MurpheyLab/NoodleBot/swimmer/solidworks/swimmer cap.SLDPRT

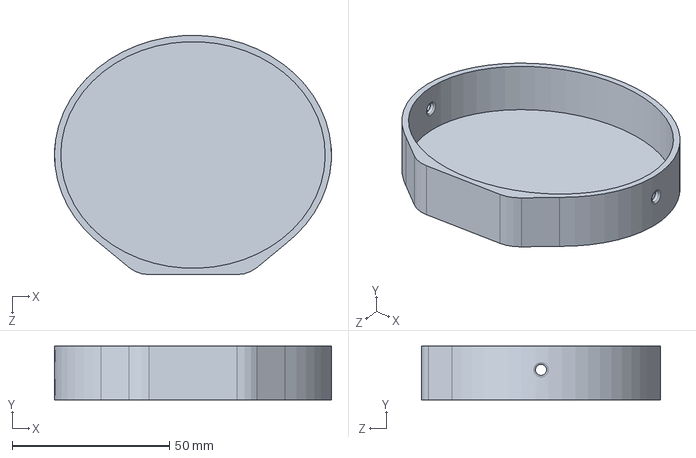
[picture p4: CAD file, 2024-09-23]
swimmer/solidworks/swimmer cap.SLDPRT
88.0 x 17.0 x 76.0 mm
