MurpheyLab/NoodleBot/swimmer/solidworks/large servo bracket.SLDPRT

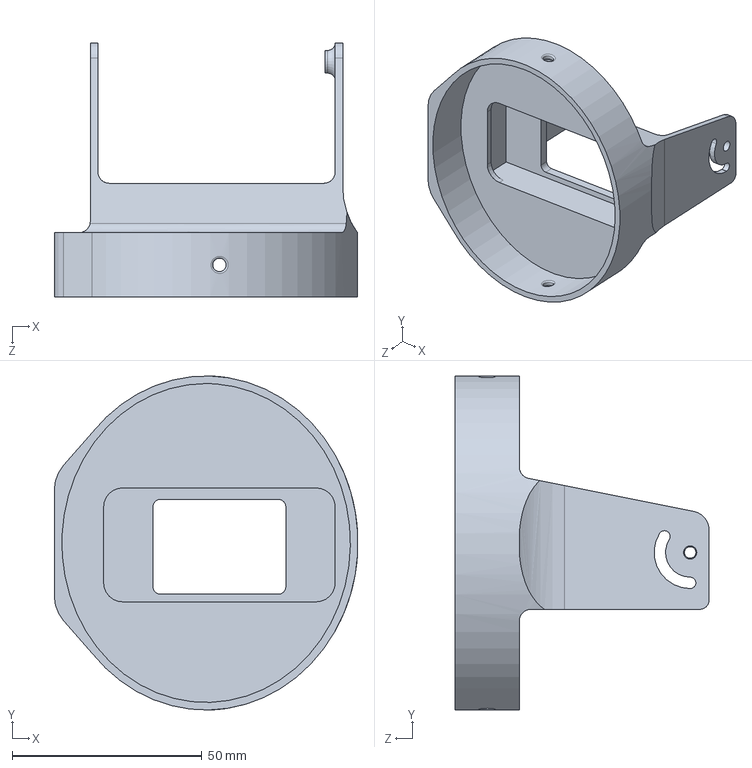
[picture p5: CAD file, 2024-09-23]
swimmer/solidworks/large servo bracket.SLDPRT
79.9 x 88.0 x 67.0 mm
