MurpheyLab/NoodleBot/swimmer/NoodleBot.ini

[devices]
modem1= 1
beacon2= 1
beacon3= 1
beacon4= 1
beacon5= 1
beacon10= 1
beacon11= 1


[zones]
zone0_id= 0
zone0_flags= 98
zone0_points= 4
zone0_point0_x= 2.750
zone0_point0_y= -1.500
zone0_point1_x= 2.750
zone0_point1_y= 1.000
zone0_point2_x= -1.000
zone0_point2_y= 1.000
zone0_point3_x= -1.000
zone0_point3_y= -1.500



[floors]
NumFloors= 16
ShowAll= 1
Floor1_BaseLevel= 0
Floor1_Height= 3500
Floor1_Selected= 1
Floor2_BaseLevel= 3500
Floor2_Height= 3500
Floor2_Selected= 1
Floor3_BaseLevel= 7000
Floor3_Height= 3500
Floor3_Selected= 1
Floor4_BaseLevel= 10500
Floor4_Height= 3500
Floor4_Selected= 1
Floor5_BaseLevel= 14000
Floor5_Height= 3500
Floor5_Selected= 1
Floor6_BaseLevel= 17500
Floor6_Height= 3500
Floor6_Selected= 1
Floor7_BaseLevel= 21000
Floor7_Height= 3500
Floor7_Selected= 1
Floor8_BaseLevel= 24500
Floor8_Height= 3500
Floor8_Selected= 1
Floor9_BaseLevel= 28000
Floor9_Height= 3500
Floor9_Selected= 1
Floor10_BaseLevel= 31500
Floor10_Height= 3500
Floor10_Selected= 1
Floor11_BaseLevel= 35000
Floor11_Height= 3500
Floor11_Selected= 1
Floor12_BaseLevel= 38500
Floor12_Height= 3500
Floor12_Selected= 1
Floor13_BaseLevel= 42000
Floor13_Height= 3500
Floor13_Selected= 1
Floor14_BaseLevel= 45500
Floor14_Height= 3500
Floor14_Selected= 1
Floor15_BaseLevel= 49000
Floor15_Height= 3500
Floor15_Selected= 1
Floor16_BaseLevel= 52500
Floor16_Height= 3500
Floor16_Selected= 1


[modem 1]
FW_Version_major= 7
FW_Version_minor= 90
FW_Version_minor2= 0
FW_Device_type= 48
FW_Version_options= 0
FW_Version_usecase= 3
Unique_device_ID= 19254B

Max_deviation_for_case= 40
Max_conditional_deviation= 100
Max_triangle_deviation= 30
Location_update_rate= 7
Maximum_speed= 5.0
Long_time_sleep= 0
Window_of_averaging= 0
Router_extrapolation= 0
Movement_filtering= 0
Use_pairs_of_beacons= 1
Update_rate_boost= 1
Minimum_signal_quality= 0
Track_with_low_signal= 0
Key_parameter_0002= 0
Temperature_of_air= 23
High_resolution_mode= 1
Service_areas_visible= 1
Service_areas_active= 0
Axis_beacon1= 0
Axis_beacon2= 0
Axis_beacon3= 0
Mass_mirror= 0
Freeze_map= 1
Jitter_mode= 0
Jitter_granularity= 2
Jitter_area= 0
TDMA_mode= 0
Measurement_mode= 0
Islands_mode= 0
All_hedges_every_cycle= 0
Approach_control= 0
Spot_filtering_enabled= 0
Spot_filter_samples= 3
Spot_filter_max_distance= 1.0
Spot_filter_in_tracking= 1
Frequencies_group_measure_mode= 0

Radio_settings_available= 1
Channel= 0
Radio_channr= 0
Radio_base_frequency= 919.000
Radio_profile= 2
Radio_modulation= 0
Radio_power_of_TX= 192
Radio_power_of_TX2= 10
Radio_channel_spacing= 49.190
Radio_intermediate_frequency= 556
Radio_offset_frequency= 0.00
Radio_deviation_frequency= 124.823
Radio_channel_bandwidth= 833.375
Radio_CCA_mode= 0
Radio_DC_blocking_filter= 1
Radio_Manchester= 0
Radio_Whitening= 1
Radio_FEC= 0

COMM_settings_available= 1
COMM_UART_speed= 0
COMM_Protocol_on_UART_USB= 0
COMM_NMEA_GPRMC= 0
COMM_NMEA_GPGGA= 1
COMM_NMEA_GPVTG= 1
COMM_NMEA_GPZDA= 1
COMM_External_device_control= 0
COMM_PA15_pin_function= 0
COMM_use_IMU_for_NMEA_pos= 0
COMM_use_IMU_for_speed_calc= 0
COMM_Streaming_dest= 0
COMM_Raw_inertial_sensors= 0
COMM_Processed_IMU_data= 0
COMM_Raw_distances= 0
COMM_Stream_quality= 0
COMM_Stream_telemetry= 0
COMM_Stream_telemetry_interval= 1
COMM_Stream_other_hedgehogs_pos= 0
COMM_user_payload_packets_number= 0
COMM_IMU2Modem_mode= 0
COMM_IMU2Modem_fusion_pos= 1
COMM_IMU2Modem_fusion_quaternion= 1
COMM_IMU2Modem_fusion_speed= 1
COMM_IMU2Modem_fusion_accel= 1
COMM_IMU2Modem_raw_accel= 1
COMM_IMU2Modem_raw_gyro= 1
COMM_IMU2Modem_raw_compass= 1


[submaps]
submap0= 1


[submap 0]
beacon2= 1
beacon3= 1
beacon4= 1
beacon5= 1
Starting_beacon_trilateration= 0
Starting_beacon_0= 4
Starting_beacon_1= 2
Starting_beacon_2= 5
Starting_beacon_3= 3
Helper_beacon= 0
Max_helper_distance_deviation= 0
Submap_is_frozen= 1
Submap_is_locked= 0
Beacons_on_top= 1
Mirror= 0
Navigation_3D= 0
Manual_build= 0
Limitation_distances_mode= 1
Maximum_distance= 5
Submap_X_shift= -0.80
Submap_Y_shift= 0.14
Submap_Z_shift= 0.00
Submap_rotation= 35500
Submap_plane_ex= 0.00
Submap_plane_ey= 0.00
Submap_plane_ez= 0.00
Service_area_height_top= 2.54
Service_area_height_bottom= 0.00
Default_hedges_height_2D= 0.10
Only_for_Z= 0
Submap_sleeping= 0
Submap_use_for_tracking= 1
Measure_temperature= 0
Measure_temperature_interval= 5
Temperature_source= 0
Temperature_source_submap= 0
Service_area_num_points= 0
Height_beacon2= 2.170
Height_beacon3= 1.840
Height_beacon4= 2.180
Height_beacon5= 2.540
Nearby_submaps_num= 0


[beacon 2]
FW_Version_major= 7
FW_Version_minor= 90
FW_Version_minor2= 0
FW_Device_type= 42
FW_Version_options= 0
FW_Version_usecase= 0
Unique_device_ID= 142E47

RSSI= -40
Vbat= 4.15

Device_is_sleeping= 0
Hedgehog_mode= 0
Position_X= 2.597
Position_Y= -0.156
Position_Z= 2.170
Minimum_threshold= 0
Manually_located= 0

Radio_settings_available= 1
Channel= 0
Radio_channr= 0
Radio_base_frequency= 919.000
Radio_profile= 2
Radio_modulation= 0
Radio_power_of_TX= 192
Radio_power_of_TX2= 10
Radio_channel_spacing= 49.190
Radio_intermediate_frequency= 556
Radio_offset_frequency= 0.00
Radio_deviation_frequency= 124.823
Radio_channel_bandwidth= 833.375
Radio_CCA_mode= 0
Radio_DC_blocking_filter= 1
Radio_Manchester= 0
Radio_Whitening= 1
Radio_FEC= 0

US_settings_available= 1
US_Mode_of_work= 0
US_Analog_power= 0
US_Analog_power_in_sleep= 0
Power_save_functions= 1
US_Power_after_transmission= 0
US_Transmitter_mode= 0
US_Frequency= 19000
US_Duty= 50
US_Number_of_periods= 20
US_TDMA_Sequence_size= 1
US_TDMA_Sequence_pos= 0
US_Amplifier= 0
US_Receiver_amplifier= 200
US_Mode_of_threshold= 0
US_Minimum_threshold= 0
US_Threshold_to_noise= 0
US_Signal_detection= 1
US_Periods_for_detector= 5
US_Min_speed_of_raise= 10.0
US_Min_over_raise_for_new_front= 30
US_Min_front_sig_noise= 30.0
US_ADC_prefilter= 0
US_ADC_digital_amplification= 0
US_Coef_of_estimated_front_quality= 2
US_AGC_low_threshold= 3
US_Speed_of_amplification_increase= 30
US_AGC_high_threshold= 20
US_Speed_of_amplification_decrease= 42
US_Receive_window_low= 0
US_Receive_window_high= 0
US_Minimum_distance_limitation= 1
US_Auto_measurements_when_radio_gaps= 1
US_Filter_selection= 3
US_RX1_normal= 1
US_RX2_normal= 1
US_RX3_normal= 1
US_RX4_normal= 1
US_RX5_normal= 1
US_RX1_frozen= 1
US_RX2_frozen= 1
US_RX3_frozen= 1
US_RX4_frozen= 1
US_RX5_frozen= 1
US_MIC1= 1
US_MIC2= 0
US_MIC3= 0
US_MIC4= 0
US_RX_Sensors_Mode= 0
US_TDMA_mode= 0
US_jitter_code= 0
US_IMU_filter_max_acceleration= 19.904
US_IMU_filter_max_speed= 5.000
US_max_speed= 5.000
US_PLATEAU_COEF= 1.0
US_MIN_DISTANCE= 0.0
US_PLATEAU_MIN_LEVEL_19KHZ= 0
US_PLATEAU_MIN_LEVEL_22KHZ= 0
US_PLATEAU_MIN_LEVEL_25KHZ= 0
US_PLATEAU_MIN_LEVEL_28KHZ= 0
US_PLATEAU_MIN_LEVEL_31KHZ= 0
US_PLATEAU_MIN_LEVEL_34KHZ= 0
US_PLATEAU_MIN_LEVEL_37KHZ= 0
US_PLATEAU_MIN_LEVEL_45KHZ= 0

Hedge_Height= 0.00

Misc_Sleep_with_external_power= 0

Pair_Pairing_mode= 0
Pair_Address_of_paired_hedge= 1
Pair_Location_againist_center= 1
Pair_Base_of_the_pair= 10
Pair_Send_location_of_center= 0
Pair_IMU_Fusion_for_angle= 0

Virtual_pen_enable= 0
Virtual_pen_mode= 0
Virtual_pen_draw_diameter= 3
Virtual_pen_erase_diameter= 3

IMUS_Worker_ID= 1
IMUS_Min_stroke_amp= 1
IMUS_filtering_param= 200
IMUS_square_coef= 50

COMM_settings_available= 1
COMM_UART_speed= 0
COMM_Protocol_on_UART_USB= 0
COMM_NMEA_GPRMC= 0
COMM_NMEA_GPGGA= 1
COMM_NMEA_GPVTG= 1
COMM_NMEA_GPZDA= 1
COMM_External_device_control= 0
COMM_PA15_pin_function= 0
COMM_use_IMU_for_NMEA_pos= 0
COMM_use_IMU_for_speed_calc= 0
COMM_Streaming_dest= 2
COMM_Raw_inertial_sensors= 0
COMM_Processed_IMU_data= 0
COMM_Raw_distances= 0
COMM_Stream_quality= 0
COMM_Stream_telemetry= 0
COMM_Stream_telemetry_interval= 0
COMM_Stream_other_hedgehogs_pos= 0
COMM_user_payload_packets_number= 0
COMM_IMU2Modem_mode= 0
COMM_IMU2Modem_fusion_pos= 0
COMM_IMU2Modem_fusion_quaternion= 0
COMM_IMU2Modem_fusion_speed= 0
COMM_IMU2Modem_fusion_accel= 0
COMM_IMU2Modem_raw_accel= 0
COMM_IMU2Modem_raw_gyro= 0
COMM_IMU2Modem_raw_compass= 0
Approach_control_beacon= 0


[beacon 3]
FW_Version_major= 7
FW_Version_minor= 90
FW_Version_minor2= 0
FW_Device_type= 42
FW_Version_options= 0
FW_Version_usecase= 0
Unique_device_ID= 154E51

RSSI= -44
Vbat= 4.05

Device_is_sleeping= 0
Hedgehog_mode= 0
Position_X= -0.076
Position_Y= -1.076
Position_Z= 1.840
Minimum_threshold= 0
Manually_located= 0

Radio_settings_available= 1
Channel= 0
Radio_channr= 0
Radio_base_frequency= 919.000
Radio_profile= 2
Radio_modulation= 0
Radio_power_of_TX= 192
Radio_power_of_TX2= 10
Radio_channel_spacing= 49.190
Radio_intermediate_frequency= 556
Radio_offset_frequency= 0.00
Radio_deviation_frequency= 124.823
Radio_channel_bandwidth= 833.375
Radio_CCA_mode= 0
Radio_DC_blocking_filter= 1
Radio_Manchester= 0
Radio_Whitening= 1
Radio_FEC= 0

US_settings_available= 1
US_Mode_of_work= 0
US_Analog_power= 0
US_Analog_power_in_sleep= 0
Power_save_functions= 1
US_Power_after_transmission= 0
US_Transmitter_mode= 0
US_Frequency= 25000
US_Duty= 50
US_Number_of_periods= 20
US_TDMA_Sequence_size= 1
US_TDMA_Sequence_pos= 0
US_Amplifier= 0
US_Receiver_amplifier= 200
US_Mode_of_threshold= 0
US_Minimum_threshold= 0
US_Threshold_to_noise= 0
US_Signal_detection= 1
US_Periods_for_detector= 5
US_Min_speed_of_raise= 10.0
US_Min_over_raise_for_new_front= 30
US_Min_front_sig_noise= 30.0
US_ADC_prefilter= 0
US_ADC_digital_amplification= 0
US_Coef_of_estimated_front_quality= 2
US_AGC_low_threshold= 3
US_Speed_of_amplification_increase= 30
US_AGC_high_threshold= 20
US_Speed_of_amplification_decrease= 42
US_Receive_window_low= 0
US_Receive_window_high= 0
US_Minimum_distance_limitation= 1
US_Auto_measurements_when_radio_gaps= 1
US_Filter_selection= 3
US_RX1_normal= 1
US_RX2_normal= 1
US_RX3_normal= 1
US_RX4_normal= 1
US_RX5_normal= 1
US_RX1_frozen= 1
US_RX2_frozen= 1
US_RX3_frozen= 1
US_RX4_frozen= 1
US_RX5_frozen= 1
US_MIC1= 1
US_MIC2= 0
US_MIC3= 0
US_MIC4= 0
US_RX_Sensors_Mode= 0
US_TDMA_mode= 0
US_jitter_code= 0
US_IMU_filter_max_acceleration= 19.904
US_IMU_filter_max_speed= 5.000
US_max_speed= 5.000
US_PLATEAU_COEF= 1.0
US_MIN_DISTANCE= 0.0
US_PLATEAU_MIN_LEVEL_19KHZ= 0
US_PLATEAU_MIN_LEVEL_22KHZ= 0
US_PLATEAU_MIN_LEVEL_25KHZ= 0
US_PLATEAU_MIN_LEVEL_28KHZ= 0
US_PLATEAU_MIN_LEVEL_31KHZ= 0
US_PLATEAU_MIN_LEVEL_34KHZ= 0
US_PLATEAU_MIN_LEVEL_37KHZ= 0
US_PLATEAU_MIN_LEVEL_45KHZ= 0

Hedge_Height= 0.00

Misc_Sleep_with_external_power= 0

Pair_Pairing_mode= 0
Pair_Address_of_paired_hedge= 1
Pair_Location_againist_center= 1
Pair_Base_of_the_pair= 10
Pair_Send_location_of_center= 0
Pair_IMU_Fusion_for_angle= 0

Virtual_pen_enable= 0
Virtual_pen_mode= 0
Virtual_pen_draw_diameter= 3
Virtual_pen_erase_diameter= 3

IMUS_Worker_ID= 1
IMUS_Min_stroke_amp= 1
IMUS_filtering_param= 200
IMUS_square_coef= 50

COMM_settings_available= 1
COMM_UART_speed= 0
COMM_Protocol_on_UART_USB= 0
COMM_NMEA_GPRMC= 0
COMM_NMEA_GPGGA= 1
COMM_NMEA_GPVTG= 1
COMM_NMEA_GPZDA= 1
COMM_External_device_control= 0
COMM_PA15_pin_function= 0
COMM_use_IMU_for_NMEA_pos= 0
COMM_use_IMU_for_speed_calc= 0
COMM_Streaming_dest= 2
COMM_Raw_inertial_sensors= 0
COMM_Processed_IMU_data= 0
COMM_Raw_distances= 0
COMM_Stream_quality= 0
COMM_Stream_telemetry= 0
COMM_Stream_telemetry_interval= 0
COMM_Stream_other_hedgehogs_pos= 0
COMM_user_payload_packets_number= 0
COMM_IMU2Modem_mode= 0
COMM_IMU2Modem_fusion_pos= 0
COMM_IMU2Modem_fusion_quaternion= 0
COMM_IMU2Modem_fusion_speed= 0
COMM_IMU2Modem_fusion_accel= 0
COMM_IMU2Modem_raw_accel= 0
COMM_IMU2Modem_raw_gyro= 0
COMM_IMU2Modem_raw_compass= 0
Approach_control_beacon= 0


[beacon 4]
FW_Version_major= 7
FW_Version_minor= 90
FW_Version_minor2= 0
FW_Device_type= 42
FW_Version_options= 0
FW_Version_usecase= 0
Unique_device_ID= 143230

RSSI= -41
Vbat= 4.07

Device_is_sleeping= 0
Hedgehog_mode= 0
Position_X= -0.800
Position_Y= 0.140
Position_Z= 2.180
Minimum_threshold= 0
Manually_located= 0

Radio_settings_available= 1
Channel= 0
Radio_channr= 0
Radio_base_frequency= 919.000
Radio_profile= 2
Radio_modulation= 0
Radio_power_of_TX= 192
Radio_power_of_TX2= 10
Radio_channel_spacing= 49.190
Radio_intermediate_frequency= 556
Radio_offset_frequency= 0.00
Radio_deviation_frequency= 124.823
Radio_channel_bandwidth= 833.375
Radio_CCA_mode= 0
Radio_DC_blocking_filter= 1
Radio_Manchester= 0
Radio_Whitening= 1
Radio_FEC= 0

US_settings_available= 1
US_Mode_of_work= 0
US_Analog_power= 0
US_Analog_power_in_sleep= 0
Power_save_functions= 1
US_Power_after_transmission= 0
US_Transmitter_mode= 0
US_Frequency= 37000
US_Duty= 50
US_Number_of_periods= 20
US_TDMA_Sequence_size= 1
US_TDMA_Sequence_pos= 0
US_Amplifier= 0
US_Receiver_amplifier= 200
US_Mode_of_threshold= 0
US_Minimum_threshold= 0
US_Threshold_to_noise= 0
US_Signal_detection= 1
US_Periods_for_detector= 5
US_Min_speed_of_raise= 10.0
US_Min_over_raise_for_new_front= 30
US_Min_front_sig_noise= 30.0
US_ADC_prefilter= 0
US_ADC_digital_amplification= 0
US_Coef_of_estimated_front_quality= 2
US_AGC_low_threshold= 3
US_Speed_of_amplification_increase= 30
US_AGC_high_threshold= 20
US_Speed_of_amplification_decrease= 42
US_Receive_window_low= 0
US_Receive_window_high= 0
US_Minimum_distance_limitation= 1
US_Auto_measurements_when_radio_gaps= 1
US_Filter_selection= 3
US_RX1_normal= 1
US_RX2_normal= 1
US_RX3_normal= 1
US_RX4_normal= 1
US_RX5_normal= 1
US_RX1_frozen= 1
US_RX2_frozen= 1
US_RX3_frozen= 1
US_RX4_frozen= 1
US_RX5_frozen= 1
US_MIC1= 1
US_MIC2= 0
US_MIC3= 0
US_MIC4= 0
US_RX_Sensors_Mode= 0
US_TDMA_mode= 0
US_jitter_code= 0
US_IMU_filter_max_acceleration= 19.904
US_IMU_filter_max_speed= 5.000
US_max_speed= 5.000
US_PLATEAU_COEF= 1.0
US_MIN_DISTANCE= 0.0
US_PLATEAU_MIN_LEVEL_19KHZ= 0
US_PLATEAU_MIN_LEVEL_22KHZ= 0
US_PLATEAU_MIN_LEVEL_25KHZ= 0
US_PLATEAU_MIN_LEVEL_28KHZ= 0
US_PLATEAU_MIN_LEVEL_31KHZ= 0
US_PLATEAU_MIN_LEVEL_34KHZ= 0
US_PLATEAU_MIN_LEVEL_37KHZ= 0
US_PLATEAU_MIN_LEVEL_45KHZ= 0

Hedge_Height= 0.00

Misc_Sleep_with_external_power= 0

Pair_Pairing_mode= 0
Pair_Address_of_paired_hedge= 1
Pair_Location_againist_center= 1
Pair_Base_of_the_pair= 10
Pair_Send_location_of_center= 0
Pair_IMU_Fusion_for_angle= 0

Virtual_pen_enable= 0
Virtual_pen_mode= 0
Virtual_pen_draw_diameter= 3
Virtual_pen_erase_diameter= 3

IMUS_Worker_ID= 1
IMUS_Min_stroke_amp= 1
IMUS_filtering_param= 200
IMUS_square_coef= 50

COMM_settings_available= 1
COMM_UART_speed= 0
COMM_Protocol_on_UART_USB= 0
COMM_NMEA_GPRMC= 0
COMM_NMEA_GPGGA= 1
COMM_NMEA_GPVTG= 1
COMM_NMEA_GPZDA= 1
COMM_External_device_control= 0
COMM_PA15_pin_function= 0
COMM_use_IMU_for_NMEA_pos= 0
COMM_use_IMU_for_speed_calc= 0
COMM_Streaming_dest= 2
COMM_Raw_inertial_sensors= 0
COMM_Processed_IMU_data= 0
COMM_Raw_distances= 0
COMM_Stream_quality= 0
COMM_Stream_telemetry= 0
COMM_Stream_telemetry_interval= 0
COMM_Stream_other_hedgehogs_pos= 0
COMM_user_payload_packets_number= 0
COMM_IMU2Modem_mode= 0
COMM_IMU2Modem_fusion_pos= 0
COMM_IMU2Modem_fusion_quaternion= 0
COMM_IMU2Modem_fusion_speed= 0
COMM_IMU2Modem_fusion_accel= 0
COMM_IMU2Modem_raw_accel= 0
COMM_IMU2Modem_raw_gyro= 0
COMM_IMU2Modem_raw_compass= 0
Approach_control_beacon= 0


[beacon 5]
FW_Version_major= 7
FW_Version_minor= 90
FW_Version_minor2= 0
FW_Device_type= 42
FW_Version_options= 0
FW_Version_usecase= 0
Unique_device_ID= 155437

RSSI= -56
Vbat= 4.18

Device_is_sleeping= 0
Hedgehog_mode= 0
Position_X= 0.535
Position_Y= 0.718
Position_Z= 2.540
Minimum_threshold= 0
Manually_located= 0

Radio_settings_available= 1
Channel= 0
Radio_channr= 0
Radio_base_frequency= 919.000
Radio_profile= 2
Radio_modulation= 0
Radio_power_of_TX= 192
Radio_power_of_TX2= 10
Radio_channel_spacing= 49.190
Radio_intermediate_frequency= 556
Radio_offset_frequency= 0.00
Radio_deviation_frequency= 124.823
Radio_channel_bandwidth= 833.375
Radio_CCA_mode= 0
Radio_DC_blocking_filter= 1
Radio_Manchester= 0
Radio_Whitening= 1
Radio_FEC= 0

US_settings_available= 1
US_Mode_of_work= 0
US_Analog_power= 0
US_Analog_power_in_sleep= 0
Power_save_functions= 1
US_Power_after_transmission= 0
US_Transmitter_mode= 0
US_Frequency= 45000
US_Duty= 50
US_Number_of_periods= 20
US_TDMA_Sequence_size= 1
US_TDMA_Sequence_pos= 0
US_Amplifier= 0
US_Receiver_amplifier= 200
US_Mode_of_threshold= 0
US_Minimum_threshold= 0
US_Threshold_to_noise= 0
US_Signal_detection= 1
US_Periods_for_detector= 5
US_Min_speed_of_raise= 10.0
US_Min_over_raise_for_new_front= 30
US_Min_front_sig_noise= 30.0
US_ADC_prefilter= 0
US_ADC_digital_amplification= 0
US_Coef_of_estimated_front_quality= 2
US_AGC_low_threshold= 3
US_Speed_of_amplification_increase= 30
US_AGC_high_threshold= 20
US_Speed_of_amplification_decrease= 42
US_Receive_window_low= 0
US_Receive_window_high= 0
US_Minimum_distance_limitation= 1
US_Auto_measurements_when_radio_gaps= 1
US_Filter_selection= 3
US_RX1_normal= 1
US_RX2_normal= 1
US_RX3_normal= 1
US_RX4_normal= 1
US_RX5_normal= 1
US_RX1_frozen= 1
US_RX2_frozen= 1
US_RX3_frozen= 1
US_RX4_frozen= 1
US_RX5_frozen= 1
US_MIC1= 1
US_MIC2= 0
US_MIC3= 0
US_MIC4= 0
US_RX_Sensors_Mode= 0
US_TDMA_mode= 0
US_jitter_code= 0
US_IMU_filter_max_acceleration= 19.904
US_IMU_filter_max_speed= 5.000
US_max_speed= 5.000
US_PLATEAU_COEF= 1.0
US_MIN_DISTANCE= 0.0
US_PLATEAU_MIN_LEVEL_19KHZ= 0
US_PLATEAU_MIN_LEVEL_22KHZ= 0
US_PLATEAU_MIN_LEVEL_25KHZ= 0
US_PLATEAU_MIN_LEVEL_28KHZ= 0
US_PLATEAU_MIN_LEVEL_31KHZ= 0
US_PLATEAU_MIN_LEVEL_34KHZ= 0
US_PLATEAU_MIN_LEVEL_37KHZ= 0
US_PLATEAU_MIN_LEVEL_45KHZ= 0

Hedge_Height= 0.00

Misc_Sleep_with_external_power= 0

Pair_Pairing_mode= 0
Pair_Address_of_paired_hedge= 1
Pair_Location_againist_center= 1
Pair_Base_of_the_pair= 10
Pair_Send_location_of_center= 0
Pair_IMU_Fusion_for_angle= 0

Virtual_pen_enable= 0
Virtual_pen_mode= 0
Virtual_pen_draw_diameter= 3
Virtual_pen_erase_diameter= 3

IMUS_Worker_ID= 1
IMUS_Min_stroke_amp= 1
IMUS_filtering_param= 200
IMUS_square_coef= 50

COMM_settings_available= 1
COMM_UART_speed= 0
COMM_Protocol_on_UART_USB= 0
COMM_NMEA_GPRMC= 0
COMM_NMEA_GPGGA= 1
COMM_NMEA_GPVTG= 1
COMM_NMEA_GPZDA= 1
COMM_External_device_control= 0
COMM_PA15_pin_function= 0
COMM_use_IMU_for_NMEA_pos= 0
COMM_use_IMU_for_speed_calc= 0
COMM_Streaming_dest= 2
COMM_Raw_inertial_sensors= 0
COMM_Processed_IMU_data= 0
COMM_Raw_distances= 0
COMM_Stream_quality= 0
COMM_Stream_telemetry= 0
COMM_Stream_telemetry_interval= 0
COMM_Stream_other_hedgehogs_pos= 0
COMM_user_payload_packets_number= 0
COMM_IMU2Modem_mode= 0
COMM_IMU2Modem_fusion_pos= 0
COMM_IMU2Modem_fusion_quaternion= 0
COMM_IMU2Modem_fusion_speed= 0
COMM_IMU2Modem_fusion_accel= 0
COMM_IMU2Modem_raw_accel= 0
COMM_IMU2Modem_raw_gyro= 0
COMM_IMU2Modem_raw_compass= 0
Approach_control_beacon= 0


[beacon 10]
FW_Version_major= 7
FW_Version_minor= 90
FW_Version_minor2= 0
FW_Device_type= 43
FW_Version_options= 0
FW_Version_usecase= 0
Unique_device_ID= 131D4C

RSSI= -38
Vbat= 3.97

Device_is_sleeping= 0
Hedgehog_mode= 1
Position_X= 0.126
Position_Y= 0.805
Position_Z= 0.000
Minimum_threshold= 0
Manually_located= 0

Radio_settings_available= 1
Channel= 0
Radio_channr= 0
Radio_base_frequency= 919.000
Radio_profile= 2
Radio_modulation= 0
Radio_power_of_TX= 192
Radio_power_of_TX2= 10
Radio_channel_spacing= 49.190
Radio_intermediate_frequency= 556
Radio_offset_frequency= 0.00
Radio_deviation_frequency= 124.823
Radio_channel_bandwidth= 833.375
Radio_CCA_mode= 0
Radio_DC_blocking_filter= 1
Radio_Manchester= 0
Radio_Whitening= 1
Radio_FEC= 0

US_settings_available= 1
US_Mode_of_work= 0
US_Analog_power= 0
US_Analog_power_in_sleep= 0
Power_save_functions= 1
US_Power_after_transmission= 0
US_Transmitter_mode= 0
US_Frequency= 31000
US_Duty= 50
US_Number_of_periods= 20
US_TDMA_Sequence_size= 1
US_TDMA_Sequence_pos= 0
US_Amplifier= 0
US_Receiver_amplifier= 200
US_Mode_of_threshold= 0
US_Minimum_threshold= 0
US_Threshold_to_noise= 0
US_Signal_detection= 1
US_Periods_for_detector= 5
US_Min_speed_of_raise= 10.0
US_Min_over_raise_for_new_front= 30
US_Min_front_sig_noise= 30.0
US_ADC_prefilter= 0
US_ADC_digital_amplification= 0
US_Coef_of_estimated_front_quality= 2
US_AGC_low_threshold= 3
US_Speed_of_amplification_increase= 30
US_AGC_high_threshold= 20
US_Speed_of_amplification_decrease= 42
US_Receive_window_low= 0
US_Receive_window_high= 0
US_Minimum_distance_limitation= 1
US_Auto_measurements_when_radio_gaps= 1
US_Filter_selection= 3
US_RX1_normal= 1
US_RX2_normal= 1
US_RX3_normal= 1
US_RX4_normal= 1
US_RX5_normal= 1
US_RX1_frozen= 1
US_RX2_frozen= 1
US_RX3_frozen= 1
US_RX4_frozen= 1
US_RX5_frozen= 1
US_MIC1= 1
US_MIC2= 0
US_MIC3= 0
US_MIC4= 0
US_RX_Sensors_Mode= 0
US_TDMA_mode= 0
US_jitter_code= 0
US_IMU_filter_max_acceleration= 19.904
US_IMU_filter_max_speed= 5.000
US_max_speed= 5.000
US_PLATEAU_COEF= 1.0
US_MIN_DISTANCE= 0.0
US_PLATEAU_MIN_LEVEL_19KHZ= 0
US_PLATEAU_MIN_LEVEL_22KHZ= 0
US_PLATEAU_MIN_LEVEL_25KHZ= 0
US_PLATEAU_MIN_LEVEL_28KHZ= 0
US_PLATEAU_MIN_LEVEL_31KHZ= 0
US_PLATEAU_MIN_LEVEL_34KHZ= 0
US_PLATEAU_MIN_LEVEL_37KHZ= 0
US_PLATEAU_MIN_LEVEL_45KHZ= 0

Hedge_Height= 0.00

Misc_Sleep_with_external_power= 0

Pair_Pairing_mode= 1
Pair_Address_of_paired_hedge= 11
Pair_Location_againist_center= 0
Pair_Base_of_the_pair= 23
Pair_Send_location_of_center= 1
Pair_IMU_Fusion_for_angle= 1

Virtual_pen_enable= 0
Virtual_pen_mode= 0
Virtual_pen_draw_diameter= 3
Virtual_pen_erase_diameter= 3

IMUS_Worker_ID= 1
IMUS_Min_stroke_amp= 1
IMUS_filtering_param= 200
IMUS_square_coef= 50

COMM_settings_available= 1
COMM_UART_speed= 0
COMM_Protocol_on_UART_USB= 0
COMM_NMEA_GPRMC= 0
COMM_NMEA_GPGGA= 1
COMM_NMEA_GPVTG= 1
COMM_NMEA_GPZDA= 1
COMM_External_device_control= 0
COMM_PA15_pin_function= 0
COMM_use_IMU_for_NMEA_pos= 0
COMM_use_IMU_for_speed_calc= 0
COMM_Streaming_dest= 2
COMM_Raw_inertial_sensors= 0
COMM_Processed_IMU_data= 0
COMM_Raw_distances= 0
COMM_Stream_quality= 0
COMM_Stream_telemetry= 0
COMM_Stream_telemetry_interval= 0
COMM_Stream_other_hedgehogs_pos= 0
COMM_user_payload_packets_number= 0
COMM_IMU2Modem_mode= 0
COMM_IMU2Modem_fusion_pos= 0
COMM_IMU2Modem_fusion_quaternion= 0
COMM_IMU2Modem_fusion_speed= 0
COMM_IMU2Modem_fusion_accel= 0
COMM_IMU2Modem_raw_accel= 0
COMM_IMU2Modem_raw_gyro= 0
COMM_IMU2Modem_raw_compass= 0
Approach_control_beacon= 0


[beacon 11]
FW_Version_major= 7
FW_Version_minor= 90
FW_Version_minor2= 0
FW_Device_type= 43
FW_Version_options= 0
FW_Version_usecase= 0
Unique_device_ID= 14344E

RSSI= -35
Vbat= 3.93

Device_is_sleeping= 0
Hedgehog_mode= 1
Position_X= 0.063
Position_Y= 0.695
Position_Z= 0.000
Minimum_threshold= 0
Manually_located= 0

Radio_settings_available= 1
Channel= 0
Radio_channr= 0
Radio_base_frequency= 919.000
Radio_profile= 2
Radio_modulation= 0
Radio_power_of_TX= 192
Radio_power_of_TX2= 10
Radio_channel_spacing= 49.190
Radio_intermediate_frequency= 556
Radio_offset_frequency= 0.00
Radio_deviation_frequency= 124.823
Radio_channel_bandwidth= 833.375
Radio_CCA_mode= 0
Radio_DC_blocking_filter= 1
Radio_Manchester= 0
Radio_Whitening= 1
Radio_FEC= 0

US_settings_available= 1
US_Mode_of_work= 0
US_Analog_power= 0
US_Analog_power_in_sleep= 0
Power_save_functions= 1
US_Power_after_transmission= 0
US_Transmitter_mode= 0
US_Frequency= 31000
US_Duty= 50
US_Number_of_periods= 20
US_TDMA_Sequence_size= 1
US_TDMA_Sequence_pos= 0
US_Amplifier= 0
US_Receiver_amplifier= 200
US_Mode_of_threshold= 0
US_Minimum_threshold= 0
US_Threshold_to_noise= 0
US_Signal_detection= 1
US_Periods_for_detector= 5
US_Min_speed_of_raise= 10.0
US_Min_over_raise_for_new_front= 30
US_Min_front_sig_noise= 30.0
US_ADC_prefilter= 0
US_ADC_digital_amplification= 0
US_Coef_of_estimated_front_quality= 2
US_AGC_low_threshold= 3
US_Speed_of_amplification_increase= 30
US_AGC_high_threshold= 20
US_Speed_of_amplification_decrease= 42
US_Receive_window_low= 0
US_Receive_window_high= 0
US_Minimum_distance_limitation= 1
US_Auto_measurements_when_radio_gaps= 1
US_Filter_selection= 3
US_RX1_normal= 1
US_RX2_normal= 1
US_RX3_normal= 1
US_RX4_normal= 1
US_RX5_normal= 1
US_RX1_frozen= 1
US_RX2_frozen= 1
US_RX3_frozen= 1
US_RX4_frozen= 1
US_RX5_frozen= 1
US_MIC1= 1
US_MIC2= 0
US_MIC3= 0
US_MIC4= 0
US_RX_Sensors_Mode= 0
US_TDMA_mode= 0
US_jitter_code= 0
US_IMU_filter_max_acceleration= 19.904
US_IMU_filter_max_speed= 5.000
US_max_speed= 5.000
US_PLATEAU_COEF= 1.0
US_MIN_DISTANCE= 0.0
US_PLATEAU_MIN_LEVEL_19KHZ= 0
US_PLATEAU_MIN_LEVEL_22KHZ= 0
US_PLATEAU_MIN_LEVEL_25KHZ= 0
US_PLATEAU_MIN_LEVEL_28KHZ= 0
US_PLATEAU_MIN_LEVEL_31KHZ= 0
US_PLATEAU_MIN_LEVEL_34KHZ= 0
US_PLATEAU_MIN_LEVEL_37KHZ= 0
US_PLATEAU_MIN_LEVEL_45KHZ= 0

Hedge_Height= 0.00

Misc_Sleep_with_external_power= 0

Pair_Pairing_mode= 1
Pair_Address_of_paired_hedge= 10
Pair_Location_againist_center= 1
Pair_Base_of_the_pair= 23
Pair_Send_location_of_center= 1
Pair_IMU_Fusion_for_angle= 1

Virtual_pen_enable= 0
Virtual_pen_mode= 0
Virtual_pen_draw_diameter= 3
Virtual_pen_erase_diameter= 3

IMUS_Worker_ID= 1
IMUS_Min_stroke_amp= 1
IMUS_filtering_param= 200
IMUS_square_coef= 50

COMM_settings_available= 1
COMM_UART_speed= 0
COMM_Protocol_on_UART_USB= 0
COMM_NMEA_GPRMC= 0
COMM_NMEA_GPGGA= 1
COMM_NMEA_GPVTG= 1
COMM_NMEA_GPZDA= 1
COMM_External_device_control= 0
COMM_PA15_pin_function= 0
COMM_use_IMU_for_NMEA_pos= 0
COMM_use_IMU_for_speed_calc= 0
COMM_Streaming_dest= 2
COMM_Raw_inertial_sensors= 0
COMM_Processed_IMU_data= 0
COMM_Raw_distances= 0
COMM_Stream_quality= 0
COMM_Stream_telemetry= 0
COMM_Stream_telemetry_interval= 0
COMM_Stream_other_hedgehogs_pos= 0
COMM_user_payload_packets_number= 0
COMM_IMU2Modem_mode= 0
COMM_IMU2Modem_fusion_pos= 0
COMM_IMU2Modem_fusion_quaternion= 0
COMM_IMU2Modem_fusion_speed= 0
COMM_IMU2Modem_fusion_accel= 0
COMM_IMU2Modem_raw_accel= 0
COMM_IMU2Modem_raw_gyro= 0
COMM_IMU2Modem_raw_compass= 0
Approach_control_beacon= 0
